mitra42/frugal-iot-hw-lora/BOM.csv

Refs | Value | MPN | LCSC | Footprint | Qty | DNP | Note
C1,C2,C4,C5,C8,C14 | 10uF | 10uF | C19702 | Capacitor_SMD:C_0603_1608Metric | 6
C3,C6,C9,C12,C13,C15 | 100nF | 100nF | C14663 | Capacitor_SMD:C_0603_1608Metric | 6 |  | filter (analog)
C7,C10,C16 | 1uF | 1uF | C15849 | Capacitor_SMD:C_0603_1608Metric | 3 |  | U7 input, close to its VIN
C11 | 100nF | 100nF | C14663 | Capacitor_SMD:C_0603_1608Metric | 1 | DNP | filter option (analog)
D1 | RED | KT-0603R | C2286 | LED_SMD:LED_0603_1608Metric | 1
D2,D4 | GREEN | KT-0805G | C2297 | LED_SMD:LED_0805_2012Metric | 2
D3 | SS34 | SS34 | C8678 | Diode_SMD:D_SMA | 1
D5 | PSM712 | PSM712-LF-T7 | C32677 | Package_TO_SOT_SMD:SOT-23 | 1
J1 | USB-C | TYPE-C-31-M-12 | C165948 | Connector_USB:USB_C_Receptacle_HRO_TYPE-C-31-M-12 | 1
J2 | J2 SENSORS 1-5 | XY308-2.54-5P | C915914 | TerminalBlock:TerminalBlock_Xinya_XY308-2.54-5P_1x05_P2.54mm_Horizontal | 1
J3 | J3 RS485 1-5 | XY308-2.54-5P | C915914 | TerminalBlock:TerminalBlock_Xinya_XY308-2.54-5P_1x05_P2.54mm_Horizontal | 1
J4 | CELL | S2B-PH-K-S | C173752 | Connector_JST:JST_PH_S2B-PH-K_1x02_P2.00mm_Horizontal | 1
J5 | SPARE GPIO | SPARE GPIO |  | Connector_PinHeader_2.54mm:PinHeader_2x05_P2.54mm_Vertical | 1 | DNP | holes only (L10)
J6 | 5V IN (aux) | XY308-2.54-2P | C557685 | TerminalBlock:TerminalBlock_Xinya_XY308-2.54-2P_1x02_P2.54mm_Horizontal | 1
J7 | EXT LED | EXT LED |  | Connector_PinHeader_2.54mm:PinHeader_1x02_P2.54mm_Vertical | 1 | DNP | off-board LED: 1 = anode, 2 = cathode
J12 | J2 SENSORS 6-10 | XY308-2.54-5P | C915914 | TerminalBlock:TerminalBlock_Xinya_XY308-2.54-5P_1x05_P2.54mm_Horizontal | 1
J13 | J3 SPARE 6-10 | XY308-2.54-5P | C915914 | TerminalBlock:TerminalBlock_Xinya_XY308-2.54-5P_1x05_P2.54mm_Horizontal | 1
JP1 | 500mA | 500mA |  | Jumper:SolderJumper-2_P1.3mm_Open_RoundedPad1.0x1.5mm | 1
JP2 | A/RX | A/RX |  | Jumper:SolderJumper-3_P1.3mm_Bridged12_RoundedPad1.0x1.5mm | 1
JP3 | B/TX | B/TX |  | Jumper:SolderJumper-3_P1.3mm_Bridged12_RoundedPad1.0x1.5mm | 1
JP4 | TERM | TERM |  | Jumper:SolderJumper-2_P1.3mm_Open_RoundedPad1.0x1.5mm | 1
Q1,Q2 | AO3401A | AO3401A | C15127 | Package_TO_SOT_SMD:SOT-23 | 2
R1,R2 | 5.1k | 5.1k | C23186 | Resistor_SMD:R_0603_1608Metric | 2
R3,R4,R14-R16 | 4.7k | 4.7k | C23162 | Resistor_SMD:R_0603_1608Metric | 5 |  | pull-up (e.g. DS18B20),with JP1: ~500 mA,~250 mA
R5,R6,R13 | 1k | 1k | C21190 | Resistor_SMD:R_0603_1608Metric | 3
R7,R10 | 100k | 100k | C25803 | Resistor_SMD:R_0603_1608Metric | 2 |  | rail off at reset
R8,R9 | 1M | 1M | C22935 | Resistor_SMD:R_0603_1608Metric | 2
R11,R12,R18,R22,R23 | 10k | 10k | C25804 | Resistor_SMD:R_0603_1608Metric | 5 |  | radio deselected while the ESP32 boots or sleeps,radio out of reset while the ESP32 sleeps,receive by default
R17 | 4.7k | 4.7k | C23162 | Resistor_SMD:R_0603_1608Metric | 1 | DNP | pull-up option (e.g. DS18B20)
R19,R20 | 680R | 680R | C23228 | Resistor_SMD:R_0603_1608Metric | 2 |  | bias
R21 | 120R | 120R | C22787 | Resistor_SMD:R_0603_1608Metric | 1
SW1 | RESET | TS-1187A-B-A-B | C318884 | Button_Switch_SMD:SW_Push_1P1T_XKB_TS-1187A | 1
SW2 | BOOT | TS-1187A-B-A-B | C318884 | Button_Switch_SMD:SW_Push_1P1T_XKB_TS-1187A | 1
TP1 | VBUS | VBUS |  | TestPoint:TestPoint_Pad_D1.5mm | 1
TP2 | VBAT | VBAT |  | TestPoint:TestPoint_Pad_D1.5mm | 1
TP3 | VSYS | VSYS |  | TestPoint:TestPoint_Pad_D1.5mm | 1
TP4 | +3V3 | +3V3 |  | TestPoint:TestPoint_Pad_D1.5mm | 1
TP5 | +3V3_SW | +3V3_SW |  | TestPoint:TestPoint_Pad_D1.5mm | 1
TP6 | +3V3_RF | +3V3_RF |  | TestPoint:TestPoint_Pad_D1.5mm | 1
TP7 | GND | GND |  | TestPoint:TestPoint_Pad_D1.5mm | 1
U1 | TP4056 | TP4056 | C16581 | Package_SO:SOIC-8-1EP_3.9x4.9mm_P1.27mm_EP2.41x3.3mm | 1 |  | TEMP grounded: no cell NTC
U2 | XB5353A | XB5353A | C80628 | Package_TO_SOT_SMD:SOT-23-5 | 1
U3,U7 | RT9080-33GJ5 | RT9080-33GJ5 | C841192 | Package_TO_SOT_SMD:TSOT-23-5 | 2
U4 | ESP32-S3-WROOM-1U-N4 | ESP32-S3-WROOM-1U-N4 | C2980296 | RF_Module:ESP32-S3-WROOM-1U | 1
U5 | SP3485EN | SP3485EN-L/TR | C8963 | Package_SO:SOIC-8_3.9x4.9mm_P1.27mm | 1
U6 | Ra-01SH | Ra-01SH | C2764087 | frugal:Ai-Thinker-Ra-01SH | 1
