mitra42/frugal-iot-hw-lora/claude-tools/schematic/circuit.py

"""Circuit definition for Frugal-IoT V0.3 LoRa (source of truth for parts and nets).
V0.2 decisions are Dn (../../v0.2-baseline/DECISIONS-V0.2.md); V0.3 decisions are Ln (../../DECISIONS.md).
Each part: dict(prefix, lib, value, fp, nets{pin:net}, dnp, lcsc, mpn, block, note, ref)
net 'NC' => no-connect marker.
"""
P = []
def part(prefix, lib, value, fp, nets, block, dnp=False, lcsc='', mpn='', rot=None, note='', ref=None):
    P.append(dict(prefix=prefix, lib=lib, value=value, fp=fp, nets=nets, block=block,
                  dnp=dnp, lcsc=lcsc, mpn=mpn, rot=rot, note=note, ref=ref))

R06 = 'Resistor_SMD:R_0603_1608Metric'; C06 = 'Capacitor_SMD:C_0603_1608Metric'
LED06 = 'LED_SMD:LED_0603_1608Metric'; LED08 = 'LED_SMD:LED_0805_2012Metric'
SMA = 'Diode_SMD:D_SMA'; SOT23 = 'Package_TO_SOT_SMD:SOT-23'
TB254 = 'TerminalBlock:TerminalBlock_Xinya_XY308-2.54-{n}P_1x0{n}_P2.54mm_Horizontal'
HDR = 'Connector_PinHeader_2.54mm:PinHeader_1x0{n}_P2.54mm_Vertical'
BTN = 'Button_Switch_SMD:SW_Push_1P1T_XKB_TS-1187A'
SJ = 'Jumper:SolderJumper-2_P1.3mm_Open_RoundedPad1.0x1.5mm'
SJ3 = 'Jumper:SolderJumper-3_P1.3mm_Bridged12_RoundedPad1.0x1.5mm'
XY = {2: ('C557685', 'XY308-2.54-2P'), 3: ('C557686', 'XY308-2.54-3P'), 5: ('C915914', 'XY308-2.54-5P')}

RES = {'10k': 'C25804', '100k': 'C25803', '1k': 'C21190', '4.7k': 'C23162', '5.1k': 'C23186',
       '1M': 'C22935', '120R': 'C22787', '680R': 'C23228'}
CAP = {'100nF': 'C14663', '1uF': 'C15849', '10uF': 'C19702'}

def R(v, a, b, blk, dnp=False, note=''):
    part('R', 'Device:R', v, R06, {'1': a, '2': b}, blk, dnp, RES.get(v, ''), note=note)
def C(v, a, b, blk, dnp=False, note=''):
    part('C', 'Device:C', v, C06, {'1': a, '2': b}, blk, dnp, CAP.get(v, ''), note=note)
def LED(col, anode, cathode, blk):  # JLCPCB Basic: red KT-0603R, green KT-0805G
    part('D', 'Device:LED', col, {'RED': LED06, 'GREEN': LED08}[col], {'2': anode, '1': cathode}, blk, rot=180,
         lcsc={'RED': 'C2286', 'GREEN': 'C2297'}[col], mpn={'RED': 'KT-0603R', 'GREEN': 'KT-0805G'}[col])
def PFET(g, s, d, blk):
    part('Q', 'Transistor_FET:AO3401A', 'AO3401A', SOT23, {'1': g, '2': s, '3': d}, blk, lcsc='C15127')
def BUTTON(a, b, blk, val):
    part('SW', 'Switch:SW_Push', val, BTN, {'1': a, '2': b}, blk, lcsc='C318884', mpn='TS-1187A-B-A-B')
def TERM(ref, n, nets, blk, val, dnp=False):
    lc, mpn = XY[n]
    part('J', f'Connector:Screw_Terminal_01x0{n}', val, TB254.format(n=n),
         {str(i + 1): net for i, net in enumerate(nets)}, blk, dnp, lc, mpn, ref=ref)

# ---------------- USB-C (power + native USB) ----------------
B = 'usb'
part('J', 'Connector:USB_C_Receptacle_USB2.0_16P', 'USB-C', 'Connector_USB:USB_C_Receptacle_HRO_TYPE-C-31-M-12',
     {'A1': 'GND', 'B1': 'GND', 'A12': 'GND', 'B12': 'GND', 'A4': 'VBUS', 'A9': 'VBUS', 'B4': 'VBUS', 'B9': 'VBUS',
      'A5': 'CC1', 'B5': 'CC2', 'A6': 'USB_D_P', 'B6': 'USB_D_P', 'A7': 'USB_D_N', 'B7': 'USB_D_N',
      'A8': 'NC', 'B8': 'NC', 'SH': 'GND'}, B, lcsc='C165948', mpn='TYPE-C-31-M-12', ref='J1')
R('5.1k', 'CC1', 'GND', B); R('5.1k', 'CC2', 'GND', B)
TERM('J6', 2, ['VBUS', 'GND'], B, '5V IN (aux)')   # D10: external 5 V beside USB; fitted from D34

# ---------------- Charger + cell protection ----------------
B = 'chg'
part('U', 'Battery_Management:TP4056-42-ESOP8', 'TP4056', 'Package_SO:SOIC-8-1EP_3.9x4.9mm_P1.27mm_EP2.41x3.3mm',
     {'1': 'GND', '2': 'CHG_PROG', '3': 'GND', '4': 'VBUS', '5': 'VBAT', '6': 'nSTDBY', '7': 'nCHRG',
      '8': 'VBUS', '9': 'GND'}, B, lcsc='C16581', note='TEMP grounded: no cell NTC')
C('10uF', 'VBUS', 'GND', B); C('10uF', 'VBAT', 'GND', B)
R('4.7k', 'CHG_PROG', 'GND', B, note='~250 mA')
R('4.7k', 'CHG_PROG', 'CHG_PROG2', B, note='with JP1: ~500 mA')
part('JP', 'Jumper:SolderJumper_2_Open', '500mA', SJ, {'1': 'CHG_PROG2', '2': 'GND'}, B)
R('1k', 'VBUS', 'LED_CHRG', B); LED('RED', 'LED_CHRG', 'nCHRG', B)
R('1k', 'VBUS', 'LED_STDBY', B); LED('GREEN', 'LED_STDBY', 'nSTDBY', B)
part('J', 'Connector:Conn_01x02_Pin', 'CELL', 'Connector_JST:JST_PH_S2B-PH-K_1x02_P2.00mm_Horizontal',
     {'1': 'CELL_NEG', '2': 'VBAT'}, B, lcsc='C173752', mpn='S2B-PH-K-S', ref='J4')
part('U', 'frugal:XB5353A', 'XB5353A', 'Package_TO_SOT_SMD:SOT-23-5',
     {'1': 'NC', '2': 'CELL_NEG', '3': 'VBAT', '4': 'GND', '5': 'GND'}, B, lcsc='C80628', mpn='XB5353A')
C('100nF', 'VBAT', 'CELL_NEG', B)

# ---------------- System power ----------------
B = 'pwr'
part('D', 'Device:D_Schottky', 'SS34', SMA, {'2': 'VBUS', '1': 'VSYS'}, B, lcsc='C8678', mpn='SS34', rot=180)
PFET('VBUS', 'VSYS', 'VBAT', B)                  # load sharing: cell feeds VSYS when USB is absent
R('100k', 'VBUS', 'GND', B)
C('10uF', 'VSYS', 'GND', B)
# RT9080 (L18): 600 mA, 2 uA quiescent; TSOT-23-5 pins as ME6211 (1 VIN, 2 GND, 3 EN, 4 NC, 5 VOUT)
RT9080 = ('Regulator_Linear:XC6220B331MR', 'RT9080-33GJ5', 'Package_TO_SOT_SMD:TSOT-23-5')
part('U', RT9080[0], RT9080[1], RT9080[2],
     {'1': 'VSYS', '3': 'VSYS', '2': 'GND', '4': 'NC', '5': '+3V3'}, B, lcsc='C841192', mpn='RT9080-33GJ5')
C('10uF', '+3V3', 'GND', B)
R('1M', 'VBAT', 'VBAT_SENSE', B); R('1M', 'VBAT_SENSE', 'GND', B); C('100nF', 'VBAT_SENSE', 'GND', B)
PFET('nRAIL_EN', '+3V3', '+3V3_SW', B)           # GPIO5 low = sensors on; pull-up keeps it off at reset
R('100k', '+3V3', 'nRAIL_EN', B, note='rail off at reset')
C('1uF', '+3V3_SW', 'GND', B)

# Test points on every supply rail (L20): bare 1.5 mm SMD pads, not in the BOM or pick-and-place
for net in ('VBUS', 'VBAT', 'VSYS', '+3V3', '+3V3_SW', '+3V3_RF', 'GND'):
    part('TP', 'Connector:TestPoint', net, 'TestPoint:TestPoint_Pad_D1.5mm', {'1': net}, B)

# ---------------- MCU: ESP32-S3-WROOM-1U (L1), pin map L3 as revised for layout (L19) ----------------
B = 'mcu'
part('U', 'RF_Module:ESP32-S3-WROOM-1', 'ESP32-S3-WROOM-1U-N4', 'RF_Module:ESP32-S3-WROOM-1U',
     {'1': 'GND', '2': '+3V3', '3': 'EN', '4': 'SENS1', '5': 'SENS2', '6': 'VBAT_SENSE', '7': 'NC',
      '8': 'nRAIL_EN', '9': 'NC', '10': 'I2C_SDA', '11': 'I2C_SCL', '12': 'LORA_NSS',
      '13': 'USB_D_N', '14': 'USB_D_P', '15': 'NC', '16': 'NC', '17': 'LORA_SCK', '18': 'LORA_MOSI',
      '19': 'LORA_MISO', '20': 'LORA_RST', '21': 'LORA_BUSY', '22': 'LORA_DIO1', '23': 'STATUS_LED',
      '24': 'GPIO47', '25': 'GPIO48', '26': 'NC', '27': 'BOOT', '28': 'NC', '29': 'GPIO36', '30': 'NC',
      '31': 'RS485_DE', '32': 'GPIO39', '33': 'NC', '34': 'GPIO41', '35': 'GPIO42',
      '36': 'RXD0', '37': 'TXD0', '38': 'GPIO2', '39': 'GPIO1', '40': 'GND', '41': 'GND'},
     B, lcsc='C2980296', mpn='ESP32-S3-WROOM-1U-N4')
C('10uF', '+3V3', 'GND', B); C('100nF', '+3V3', 'GND', B)
R('10k', '+3V3', 'EN', B); C('1uF', 'EN', 'GND', B); BUTTON('EN', 'GND', B, 'RESET')
R('10k', '+3V3', 'BOOT', B); BUTTON('BOOT', 'GND', B, 'BOOT')
R('1k', '+3V3', 'LED_STAT', B); LED('GREEN', 'LED_STAT', 'STATUS_LED', B)
part('J', 'Connector:Conn_01x02_Pin', 'EXT LED', HDR.format(n=2), {'1': 'LED_STAT', '2': 'STATUS_LED'}, B,
     dnp=True, ref='J7', note='off-board LED: 1 = anode, 2 = cathode')

# ---------------- Sensor connectors ----------------
B = 'conn'
R('4.7k', '+3V3_SW', 'I2C_SDA', B); R('4.7k', '+3V3_SW', 'I2C_SCL', B)
# Fitted (D31): SENS1 pull-up (e.g. DS18B20), SENS2 filter (analog); the other two stay options.
for s_, fit_r, fit_c in (('SENS1', True, False), ('SENS2', False, True)):
    R('4.7k', '+3V3_SW', s_, B, dnp=not fit_r, note='pull-up (e.g. DS18B20)' if fit_r else 'pull-up option (e.g. DS18B20)')
    C('100nF', s_, 'GND', B, dnp=not fit_c, note='filter (analog)' if fit_c else 'filter option (analog)')
# J2: main sensor connector = two 5-way XY308 side by side, pins 1-10 as v0.1 (D4)
TERM('J2', 5, ['GND', 'I2C_SDA', 'I2C_SCL', '+3V3_SW', 'GND'], B, 'J2 SENSORS 1-5')
TERM('J12', 5, ['SENS1', '+3V3_SW', 'GND', 'SENS2', '+3V3_SW'], B, 'J2 SENSORS 6-10')
# J3: same layout (D5); pins 2-3 = RS485 A/B as delivered (JP2/JP3 bridged 1-2), or UART RX/TX (cut, bridge 2-3)
TERM('J3', 5, ['GND', 'J3_P2', 'J3_P3', '+3V3_SW', 'GND'], B, 'J3 RS485 1-5')   # Modbus fitted (L9)
TERM('J13', 5, ['GPIO1', '+3V3_SW', 'GND', 'GPIO2', '+3V3_SW'], B, 'J3 SPARE 6-10')
part('JP', 'Jumper:SolderJumper_3_Bridged12', 'A/RX', SJ3, {'1': 'RS485_A', '2': 'J3_P2', '3': 'RXD0'}, B)
part('JP', 'Jumper:SolderJumper_3_Bridged12', 'B/TX', SJ3, {'1': 'RS485_B', '2': 'J3_P3', '3': 'TXD0'}, B)
# J5: spare GPIOs on a 2 x 5 block of unfitted 2.54 mm holes (L10; 2 x 5 rather than a row, for layout, L19).
# Hole 6 is a second 3V3_SW; hole 4 is unconnected (boxed in by tracks): GPIO37/40 could not be routed to
# either (L19, Mitra 31 Oct).
part('J', 'Connector_Generic:Conn_02x05_Odd_Even', 'SPARE GPIO', 'Connector_PinHeader_2.54mm:PinHeader_2x05_P2.54mm_Vertical',
     {'1': 'GND', '2': '+3V3_SW', '3': 'GPIO36', '4': 'NC', '5': 'GPIO39', '6': '+3V3_SW', '7': 'GPIO41',
      '8': 'GPIO42', '9': 'GPIO47', '10': 'GPIO48'}, B, dnp=True, ref='J5', note='holes only (L10)')

# ---------------- RS485 (fitted by default, L9 / D29; omit to save cost) ----------------
B = 'rs485'
part('U', 'Interface_UART:SP3485EN', 'SP3485EN', 'Package_SO:SOIC-8_3.9x4.9mm_P1.27mm',
     {'1': 'RXD0', '2': 'RS485_DE', '3': 'RS485_DE', '4': 'TXD0', '5': 'GND', '6': 'RS485_A', '7': 'RS485_B',
      '8': '+3V3_SW'}, B, lcsc='C8963', mpn='SP3485EN-L/TR')
C('100nF', '+3V3_SW', 'GND', B)
R('10k', 'RS485_DE', 'GND', B, note='receive by default')
R('680R', '+3V3_SW', 'RS485_A', B, note='bias'); R('680R', 'RS485_B', 'GND', B, note='bias')
R('120R', 'RS485_A', 'RS485_TERM', B)
part('JP', 'Jumper:SolderJumper_2_Open', 'TERM', SJ, {'1': 'RS485_TERM', '2': 'RS485_B'}, B)
part('D', 'Diode:SM712_SOT23', 'PSM712', SOT23, {'1': 'RS485_A', '2': 'RS485_B', '3': 'GND'}, B,
     lcsc='C32677', mpn='PSM712-LF-T7')

# ---------------- LoRa radio: Ai-Thinker Ra-01SH, SX1262 (L2, L4) ----------------
# Pins per Ai-Thinker Ra-01SH specification V1.1 (../../datasheets/). The module's antenna switch is driven
# by the SX1262's DIO2 inside the module (TXEN is DIO2, RXEN not connected), it has a crystal (DIO3 unused),
# and an IPEX socket for the antenna, so pad 1 (ANT) is left unconnected.
B = 'lora'
part('U', 'frugal:Ra-01SH', 'Ra-01SH', 'frugal:Ai-Thinker-Ra-01SH',
     {'1': 'NC', '2': 'GND', '3': '+3V3_RF', '4': 'LORA_RST', '5': 'NC', '6': 'LORA_DIO1', '7': 'NC', '8': 'NC',
      '9': 'GND', '10': 'LORA_BUSY', '11': 'NC', '12': 'LORA_SCK', '13': 'LORA_MISO', '14': 'LORA_MOSI',
      '15': 'LORA_NSS', '16': 'GND'}, B, lcsc='C2764087', mpn='Ra-01SH')
C('10uF', '+3V3_RF', 'GND', B); C('100nF', '+3V3_RF', 'GND', B)
R('10k', '+3V3_RF', 'LORA_NSS', B, note='radio deselected while the ESP32 boots or sleeps')
R('10k', '+3V3_RF', 'LORA_RST', B, note='radio out of reset while the ESP32 sleeps')
# The radio's own regulator (L18): isolates it from the ESP32's WiFi load steps; always on (EN = VIN), as
# LoRaMesher sleeps the radio over SPI and never powers it off.
part('U', RT9080[0], RT9080[1], RT9080[2],
     {'1': 'VSYS', '3': 'VSYS', '2': 'GND', '4': 'NC', '5': '+3V3_RF'}, B, lcsc='C841192', mpn='RT9080-33GJ5')
C('1uF', 'VSYS', 'GND', B, note='U7 input, close to its VIN')
