mitra42/frugal-iot-hw-lora/(commit log)

2026-10-30 Start Frugal-IoT V0.3 (LoRa) from V0.2 revision 4
    - New README and DECISIONS: requirements, proposed decisions
    (ESP32-S3-WROOM-1U + Ai-Thinker Ra-01SH, pin map, power, size, cost)
    and open questions.
    - V0.2's outputs, README and decision log moved to v0.2-baseline/.
    The KiCad project and claude-tools stay as the starting point.
    Claude-Session: https://claude.ai/code/session_01BQeMed5VuFdLpBSsKxvFwD
    [BOM.csv, BOM_JLCPCB.csv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]
2026-10-30 Requirements agreed: S3, Ra-01SH, Modbus fitted, spare-pin holes, gateway
    Answers to Q1, Q2, Q4, Q5, Q6 recorded as L1, L2, L9, L10, L11.
    Q3 (power budget) left open, to decide later.
    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
2026-10-30 V0.3 schematic: ESP32-S3-WROOM-1U + Ra-01SH LoRa, two RT9080 regulators
    - KiCad project renamed frugal_iot_v03; schematic generated from circuit.py
    (netlist matches the spec, ERC clean). SCHEMATIC.pdf, BOM.csv and
    COST-ESTIMATE.txt (about $17.31/board at 10, $11.57 at 100).
    - ESP32-S3-WROOM-1U with the agreed pin map; radio on the Heltec V3/V4 GPIOs.
    - Ai-Thinker Ra-01SH (SX1262): project symbol and footprint from Ai-Thinker's
    spec (datasheets/); NSS and RESET pull-ups as the Heltec V3.
    - Two RT9080-33GJ5 LDOs replace the ME6211: one for the ESP32, one for the
    radio (2 uA quiescent each, always on).
    - Spare GPIOs on a row of unfitted holes (J5).
    - DECISIONS L12-L18; L6 updated after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
    [BOM.csv, bom.csv, frugal_iot_v02.kicad_sch, frugal_iot_v03.kicad_pcb, frugal_iot_v03.kicad_sch]
2026-10-30 README: features and files for the LoRa board, from the V0.2 README
    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
2026-10-31 V0.3 layout: 84 x 37 mm, routed, test points, JLCPCB files
    - Placement and pin-map changes for routing (DECISIONS L19): module top-left,
    Ra-01SH below-right rotated to face it, sensors on GPIO4/5, J3 spares on
    GPIO1/2, RS485 DE on GPIO38, J5 a 2x5 block at the top edge with six spare
    GPIOs (holes 4 and 6 unconnected), J4 by the charger, J6 by the USB-C,
    0.35 mm no-track strip along the edges.
    - Test points TP1-TP7 on VBUS, VBAT, VSYS, +3V3, +3V3_SW, +3V3_RF and GND,
    labelled with their rail names (L20).
    - Routed with Freerouting in repeated runs plus a small grid router for the
    last connections; DRC 0 unconnected, schematic parity 0.
    - PCB-LAYOUT.pdf, fabrication/ (gerbers, BOM,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
    [BOM.csv, BOM_JLCPCB.csv, before_backlabels.kicad_pcb, before_import.kicad_pcb, before_islands.kicad_pcb, before_join.kicad_pcb, before_polarity.kicad_pcb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]
2026-10-31 J5: hole 6 is a second 3V3_SW, hole 4 unconnected
    GPIO37/40 couldn't be routed to J5 holes 4 and 6. Hole 6 now joins the
    3V3_SW track beside it; hole 4 is boxed in by tracks on both layers, so it
    stays unconnected (labelled NC). Schematic, board, back labels, JLCPCB files,
    PCB-LAYOUT.pdf, README and DECISIONS (L19) updated. DRC: 0 unconnected,
    schematic parity 0.
    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
    [frugal_iot_v03.kicad_pcb, frugal_iot_v03.kicad_sch]
2026-11-01 README: LoRa antennas for regular and gateway nodes, with low-cost sources
    Adds an Antennas section (node whip vs internal FPC, gateway outdoor antenna, EIRP limits, AliExpress sources) and decision L21. Antennas are off-board and not in the generated BOM.csv.
    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
